rushikeshtangirala/hexapod_new/docs/review/Paper_Comparison.pptx

Comparison with published work

Xiang, L. et al. (2024). Development of a bionic hexapod robot with adaptive gait and clearance for enhanced agricultural field scouting. Frontiers in Robotics and AI, 11:1426269.

| Xiang et al., 2024 | Our project
Topology | 6 legs × 3 DOF, tripod gait as base | Same
Structure | Carbon fibre and CNC aluminium, under 10 kg | 3D printed PLA, 3.39 kg
Foot trajectory | Sinusoidal joint modulation. IK deliberately avoided at run time | Closed-form analytic IK, solved at 50 Hz
Commanding | A gait mode is selected | A body velocity is commanded, stride is derived
Simulation | SolidWorks → Simulink Simscape | AutoCAD → URDF → Gazebo, ros2_control
Sensing | IMU and one force sensor per foot | Foot sensors modelled, currently disabled
Validation | Field trials: slopes to 17°, pitch −11.5° to 8.6°, 14.4 % energy saved per obstacle | 498 offline assertions, IK exact to 3.5×10⁻¹⁶ m

The key difference
They avoid inverse kinematics at run time because numerical IK is expensive. Ours is closed form, so it costs a fixed handful of trigonometric calls and buys the ability to command a body velocity directly.

Where we sit
They have hardware and field trials; we have complete simulation and proven mathematics. Their sensing package is essentially our next-phase list.

Notes: One slide, kept separate from the main deck.

Why this paper: it is nearly the same machine. Six legs, three degrees of freedom each, tripod gait as the starting point, kinematics presented, simulation before hardware. So every difference is a real engineering choice rather than an accident of scale.

Their contribution is a terrain-adaptive gait with two clearance modes, 6 cm marching and 18 cm step-over, so the robot climbs obstacles instead of walking around them. That saves 14.4 percent of the energy per obstacle.

THE POINT TO MAKE. They deliberately avoid inverse kinematics at run time. The paper says computing landing points with IK generates many complex computations and costs time and energy, so they drive the joints with sinusoids instead. That objection applies to NUMERICAL IK, which iterates. Ours is closed form: a fixed handful of trigonometric calls, no iteration, no convergence risk. It is cheap, and it buys something their method cannot have. With sinusoids you select a gait mode. With analytic IK you command a body velocity and the stride for every leg follows from geometry, which is why walking, strafing and turning are one piece of code.

Say it in one line: they trade commandability for computation, we trade computation for commandability, and closed form is what makes that trade affordable. Both are correct engineering. Theirs is right for a battery-limited scouting robot where cost of transport is the headline metric.

Second point, validation. They validate empirically in the field, which needs hardware. We validate formally offline. Complementary, and ours caught a sign error that field testing would likely have dismissed as needing tuning.

Do not imply parity of stage. Say plainly: this paper is where we intend to be at the end of the project.

If asked what we would do differently after reading it: adopt cost of transport as a metric, we have no energy measure at all; add the IMU earlier; and reconsider using CNC aluminium for stressed parts rather than printing everything, which is how they reach 8 kg payload.
