rushikeshtangirala/hexapod_new/docs/review/Hexapod_First_Review_FINAL.pptx

18-DOF Walking Hexapod Robot

Design, Kinematic Analysis and Simulation in ROS 2 and Gazebo

First Review

Pappu Sai Varun (23BME7002)
Akshay Veeranki (23BME7009)
Mohammed Shreyanshu Gumshi (23BME7015)
Tangirala Rushikesh (23BME7073)
Guide: Dr Santosh Kumar Sahu
Department of Mechanical Engineering, VIT-AP University

Notes: Good morning. We are presenting the first review of our final year project, an eighteen degree of freedom walking hexapod robot.

We designed the robot in AutoCAD, analysed the parts in ANSYS, studied the foot trajectory in MATLAB, and built a full simulation in ROS 2 and Gazebo where it now walks under our control.

## Slide 2

Why a hexapod

Six legs turn balancing into a geometry problem

• Wheels need continuous ground. Legs only need somewhere to place a foot.
• Stable when the centre of mass sits inside the triangle of feet on the ground.
• Three feet is the minimum for a triangle, so three legs can lift at once.
• Stability is checked with geometry, not controlled continuously.

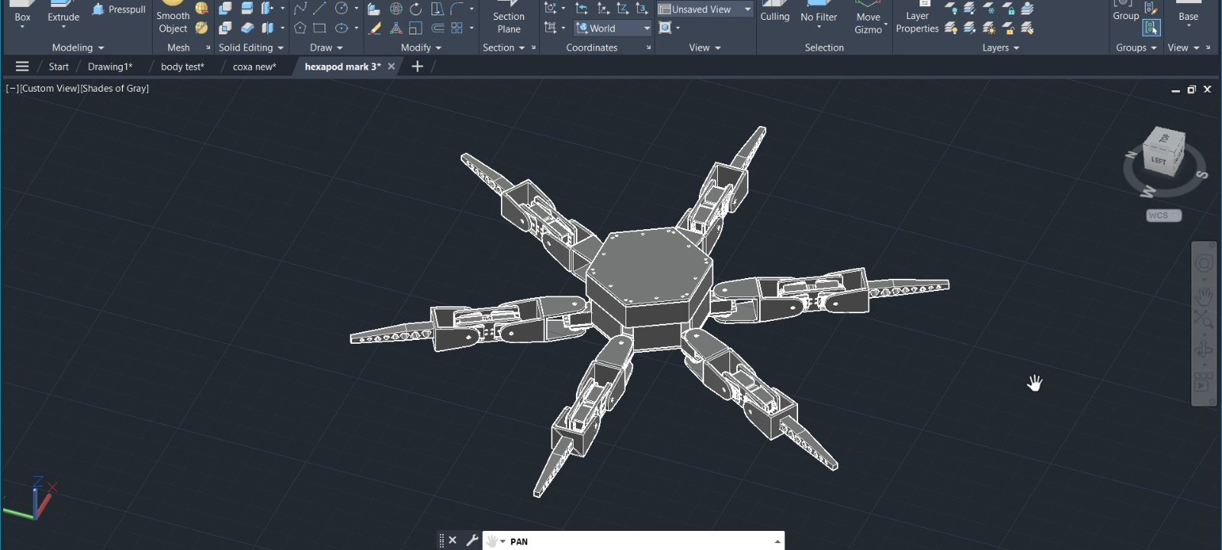
[picture p1: figure]

AutoCAD assembly, six legs about a hexagonal chassis

Notes: Why legs and not wheels. Wheels need continuous ground, legs only need places to put a foot.

Why six legs. A robot is stable when its centre of mass sits inside the triangle of feet touching the ground. Three feet is the minimum for a triangle, so a hexapod can lift three legs and stay stable. Stability becomes something we CHECK with geometry rather than something we control every instant, like a biped must.

## Slide 3

Objectives

Accurate model
AutoCAD to ROS 2, with measured masses and inertia

1

Solve the leg exactly
Closed form forward and inverse kinematics

2

Analyse the motion
Foot path, velocity, acceleration and force in MATLAB

Check the structure
ANSYS on the loaded parts

3

4

Make it walk
Tripod gait from a velocity command, simulated in Gazebo

5

Stay hardware ready
Moving to servos is a settings change

6

Notes: Our objectives. Read them, do not linger.

Objective two is the mechanical core: an exact closed form solution for the leg, not a numerical one.

Objective six is what matters for the next phase. The software is arranged so that moving to real servos is a settings change, not a rewrite.

## Slide 4

The leg

Three joints per leg, eighteen in the robot

Joint functions
Coxa θ₁ swings the leg sideways, about a vertical axis
Femur θ₂ lifts and lowers, about a horizontal axis
Tibia θ₃ extends the foot, about a parallel axis

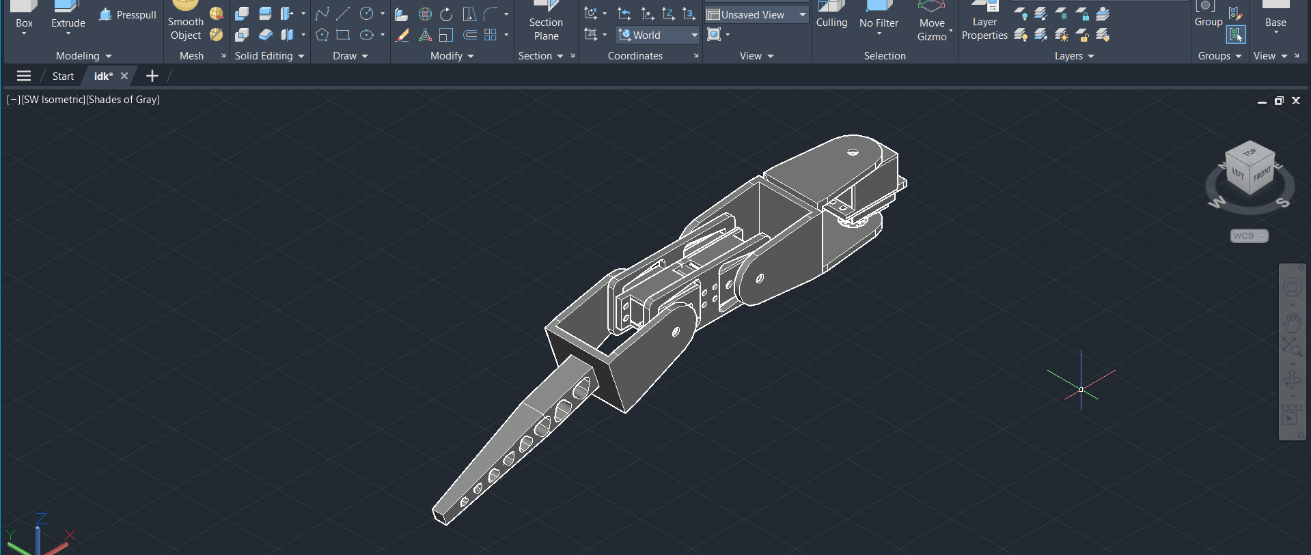
[picture p2: figure]

18

6

joints

legs

3.39

25

AutoCAD, single leg assembly

kg

links

Notes: This is one leg. Three joints, named after insect anatomy, which is the convention in legged robotics.

Coxa turns about a vertical axis and swings the leg sideways. Femur and tibia both turn about horizontal axes and move the foot in a vertical plane.

Point at the CAD: the three pivots, and the servo mounting at each.

## Slide 5

Mechanical parts

Every part modelled in AutoCAD and designed for 3D printing

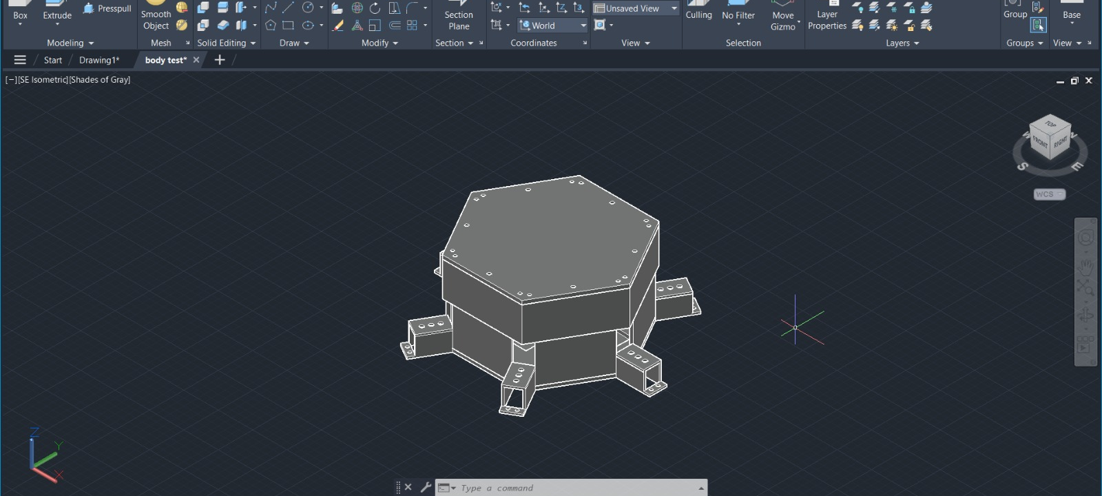
[picture p3: figure]
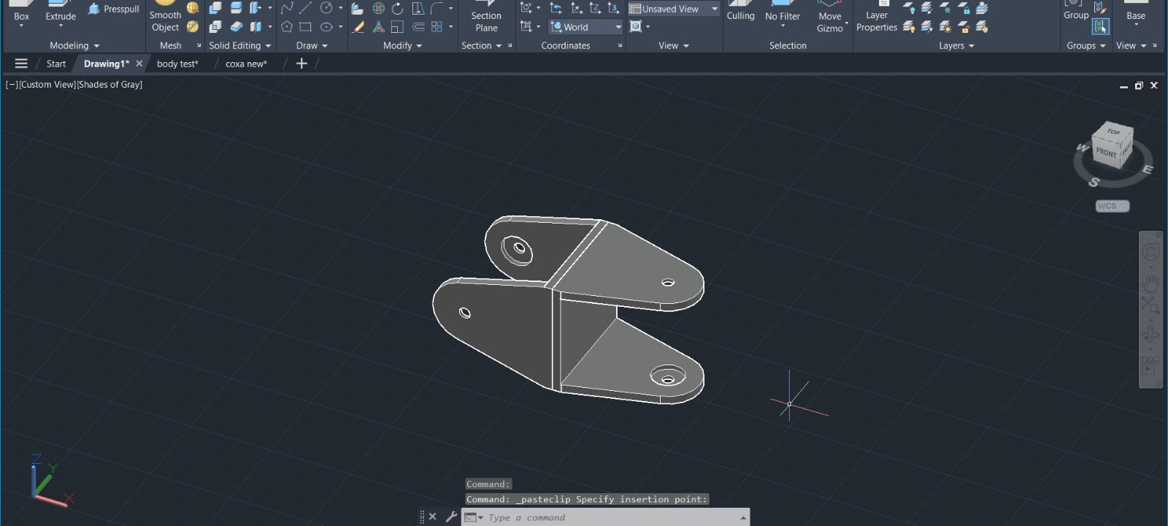
[picture p4: figure]

coxabracket

Chassis

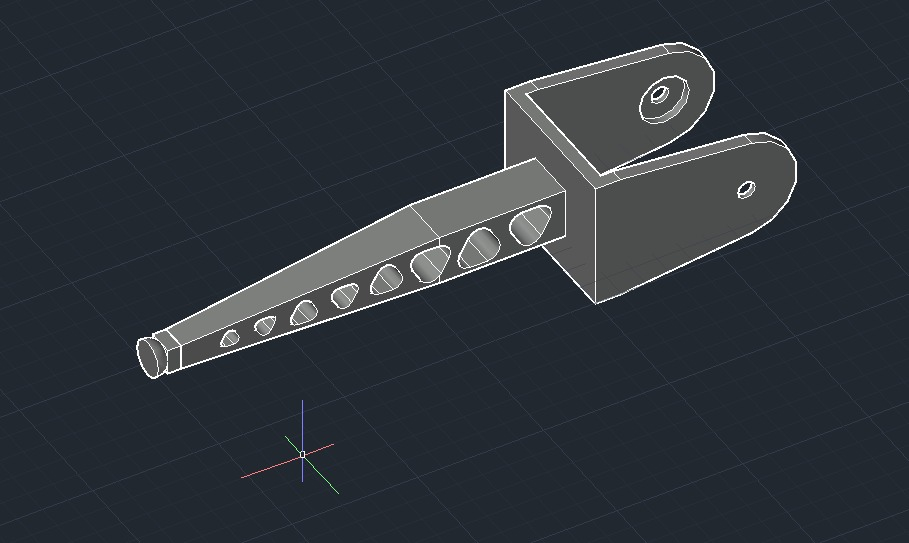
[picture p5: figure]

Tibia

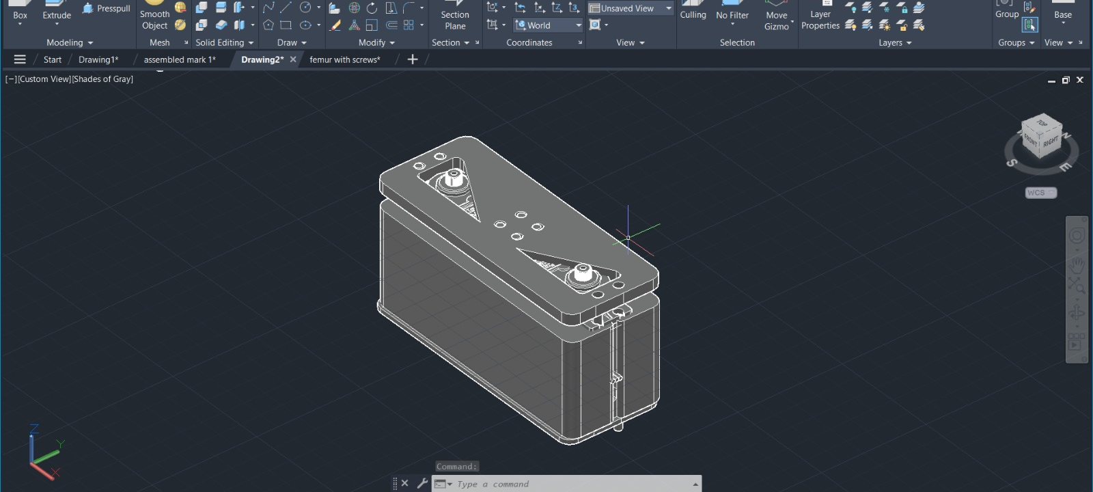
[picture p6: figure]

femur joint

Notes: The individual parts, all modelled by us in AutoCAD.

The chassis is a hexagonal frame carrying six coxa servos, the battery and the electronics. The femur is a bracket. The tibia is the long reaching member that touches the ground.

All parts are designed for 3D printing in PLA, which is what sets the masses we use in simulation.

## Slide 6

The leg as a mechanism

An RRR serial chain, and one deliberate axis choice

• Three revolute joints in series, so three degrees of freedom per leg.
• Coxa axis vertical. Femur and tibia axes horizontal and parallel to each other.
• Because those two axes are parallel, the leg beyond the coxa stays in ONE vertical plane.
• The coxa angle only selects which plane that is.
• So a 3D positioning problem reduces to a 2D two-link problem, which has an exact solution.
• In stance, the loaded legs plus the ground and body form closed chains.

Six identical legs, mounted at different yaw angles, so one solution serves all of them.

Why this matters
A general 3-DOF chain needs a numerical solver, which is slower and can fail to converge in the middle of a step.
Our arrangement gives a closed form answer every time, in a fixed number of operations.

Notes: Treating the leg as a mechanism. It is an open serial chain of three revolute joints, an RRR chain, so it has three degrees of freedom and can place its foot anywhere in a three dimensional workspace.

The important structural point is the axis arrangement. The coxa axis is vertical. The femur and tibia axes are horizontal AND PARALLEL to each other. Because those two are parallel, everything beyond the coxa is confined to one vertical plane.

In stance, three legs plus the ground and the body form closed kinematic chains, which is what carries the load.

## Slide 7

Forward kinematics

Given the joint angles, where is the foot?

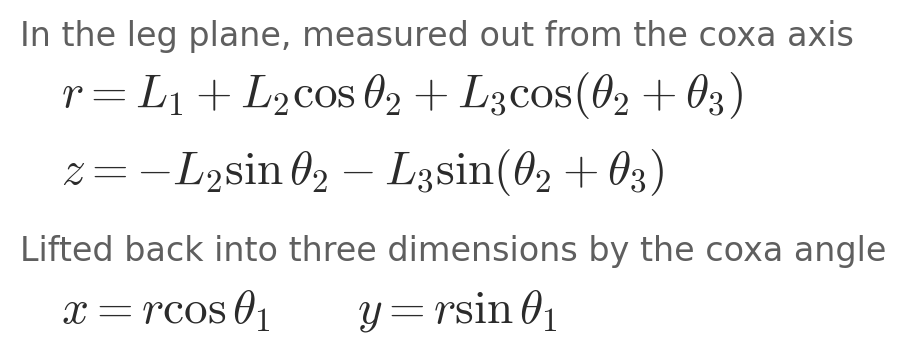
[picture p7: figure]

Link lengths
L₁ = 150.0 mm coxa
L₂ = 116.6 mm femur
L₃ = 150.0 mm tibia
Positive θ₂ and θ₃ move the foot downward, from the right handed axis convention.

Verified stance solution: θ₁ = 0°, θ₂ = 15.44°, θ₃ = 67.82°, giving a foot 0.280 m out and 0.180 m below the body.

Notes: Forward kinematics. Given the three joint angles, where is the foot.

Work in the leg plane first. r is how far out the foot is from the coxa axis, z is how far down. Each term is one link projected onto that plane.

Then lift it back into three dimensions by rotating through the coxa angle.

The minus signs on z come from the axis convention: rotation about the positive Y axis carries the X direction toward negative Z, so a positive femur angle moves the foot DOWN. We kept the mathematically clean right handed axes and documented the consequence.

## Slide 8

Inverse kinematics

Given the foot position, what should the joint angles be?

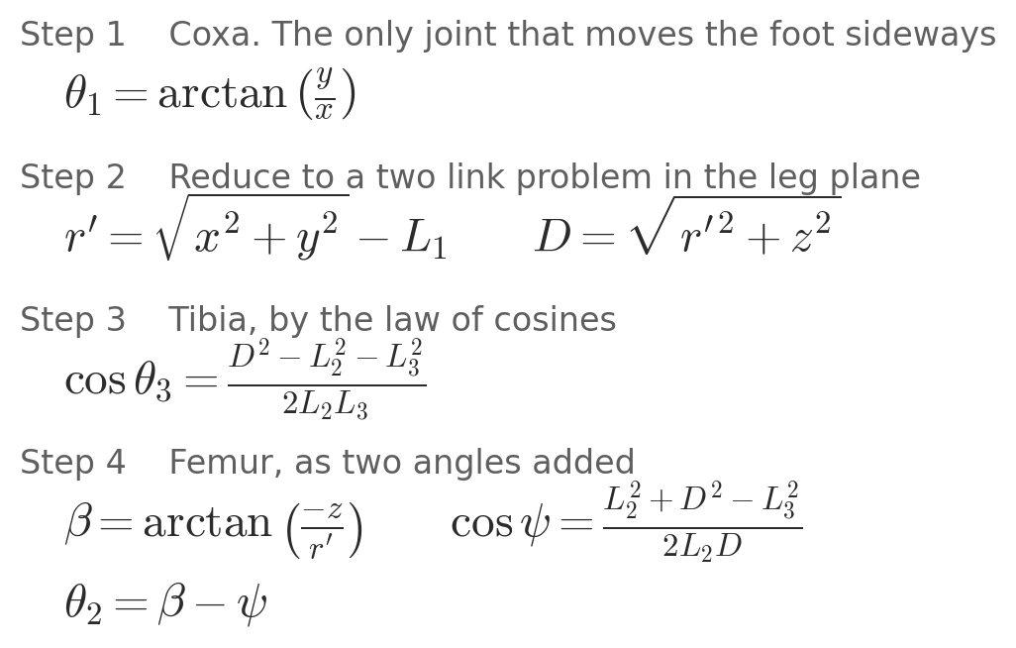
[picture p8: figure]

Checked numerically: forward → inverse → forward closes to 3.5 × 10⁻¹⁶ m, the precision limit of the computer.

Why it matters
This runs 50 times a second, for all six legs, every time the robot takes a step.
Closed form means a fixed cost and no possibility of failing to converge part way through a step.

Notes: Inverse kinematics, the one that actually runs on the robot fifty times a second. Given where we want the foot, what should the joint angles be.

Step one: the coxa is the only joint that can move the foot sideways, so its angle comes straight from the horizontal direction to the target.

Step two: shift the origin out to the femur joint. Now it is two links reaching a point, and D is the straight line distance to it.

Step three: the tibia angle from the law of cosines on the triangle made by the two link lengths and D.

Step four: the femur angle is two angles added. Beta is the elevation of the target, psi is the angle between the femur and the line to the target.

No iteration anywhere. Same number of operations every time.

## Slide 9

Mass and inertia

Calculated from the CAD volumes, then the servos added

Part | Length | Mass | Made up of
Body | 312.7 mm | 1.310 kg | frame, 6 coxa servos, battery, electronics
Coxa | 150.0 mm | 0.201 kg | printed 0.141 + femur servo 0.060
Femur | 116.6 mm | 0.101 kg | printed 0.041 + tibia servo 0.060
Tibia | 150.0 mm | 0.035 kg | printed part only

Inertia tensors
Computed in closed form for a box and for cylinders, about each part's own centre of mass. These are exact, not estimates.
Total mass 3.39 kg. Standing on three legs, each foot carries about 10.9 N.

Servo mass belongs to the part it is bolted to, not the part it moves.

Notes: The masses that go into the simulation. These are calculated from the measured volume of each CAD part at PLA density, then the servo masses added.

One detail that is easy to get backwards: a servo's mass belongs to the part it is BOLTED TO, not the part it drives. The tibia servo sits on the femur. All six coxa servos sit on the body.

What matters most is not the absolute mass but the RATIO across each joint, because the physics solver inverts the mass matrix every step and its conditioning depends on those ratios.

## Slide 10

Structural analysis

ANSYS on the parts that carry the standing load

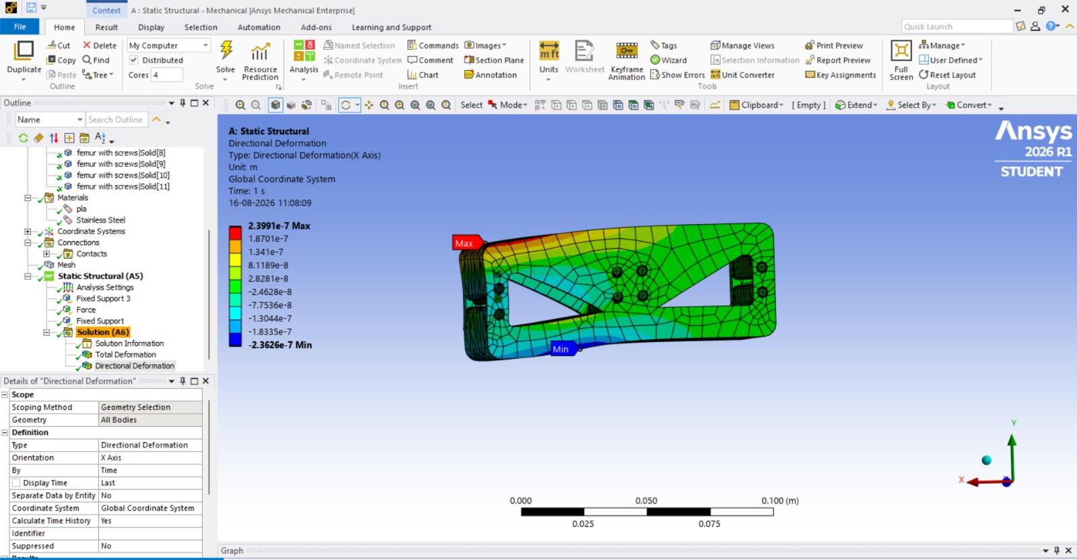
[picture p9: figure]

Static structural, femur bracket

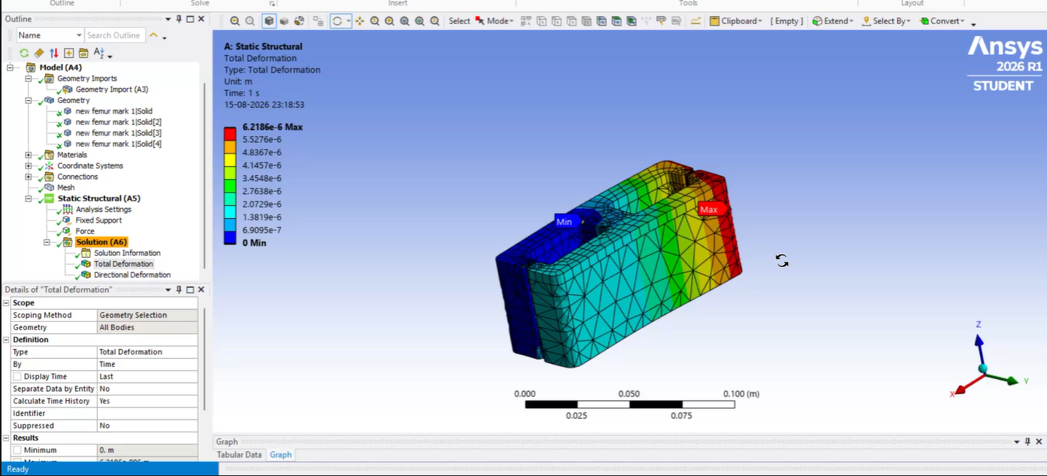
[picture p10: figure]

Total deformation, chassis

Load case: 3.39 kg standing on three legs → about 10.9 N per foot Peak stress [ ] Max deformation [ ] Factor of safety [ ]

Notes: Structural analysis in ANSYS on the loaded parts.

The load case comes straight from the mass figure on the previous slide. The robot weighs 3.39 kg, it stands on three legs at a time, so each foot carries about 10.9 newtons.

Give your peak stress and the factor of safety, then the maximum deflection. If the parts passed, say so plainly.

## Slide 11

Tripod gait

Three feet always down, and the stride follows from the speed

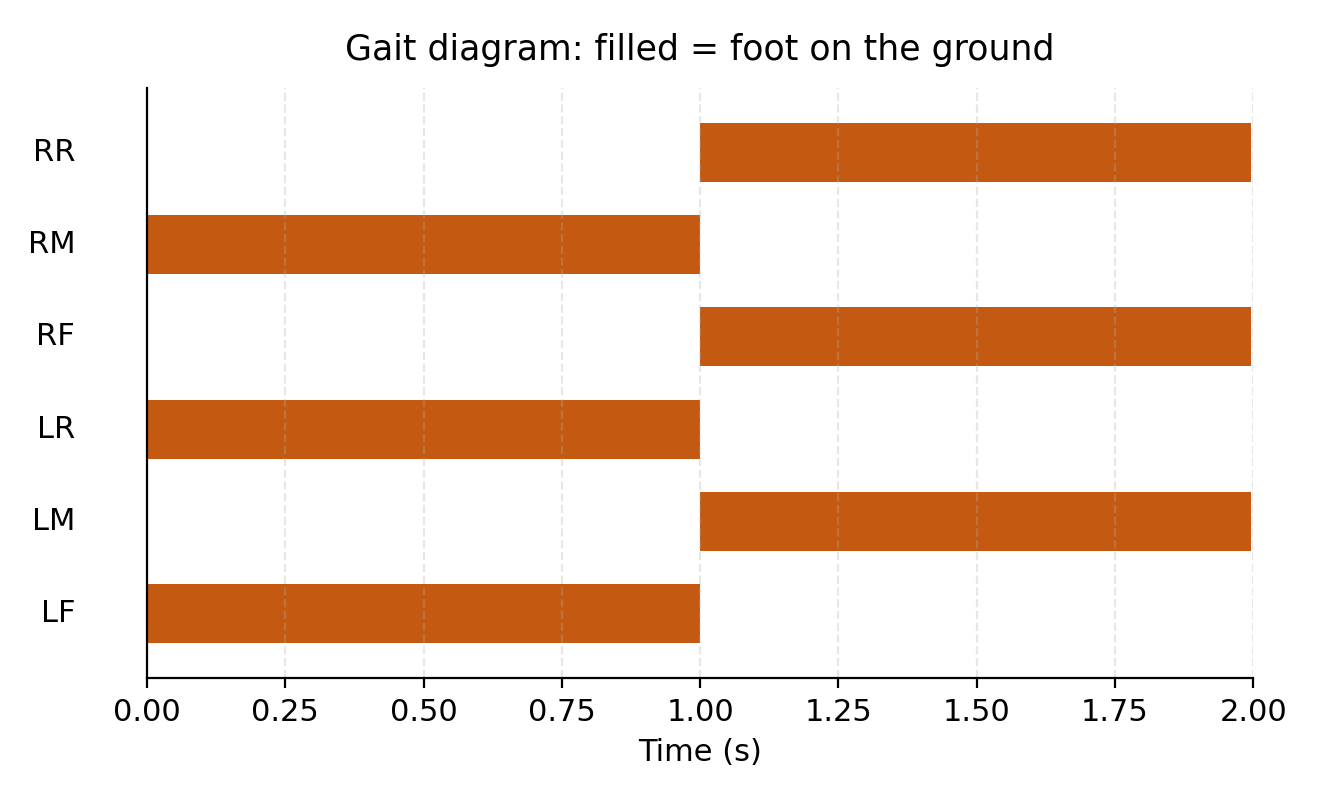
[picture p11: figure]

Step length is not a tuning knob. It is forced by the commanded speed and the time a foot spends on the ground. Choosing it freely would make the feet slide.

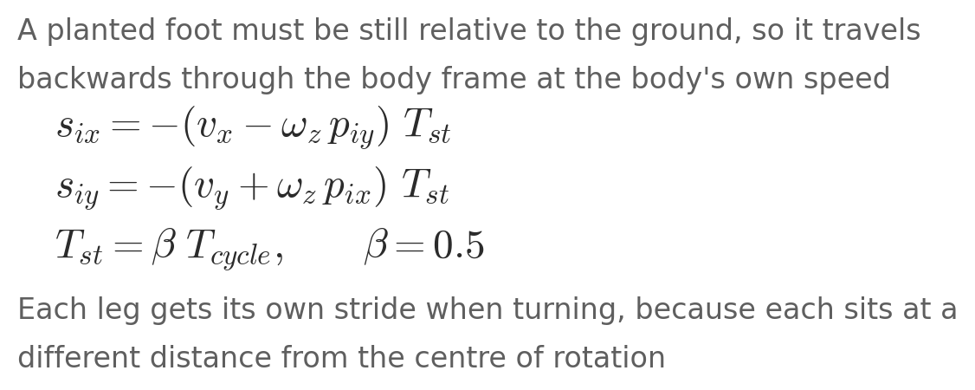
[picture p12: figure]

Notes: The walking pattern. Six legs in two groups of three, exactly half a cycle apart. One group pushes while the other swings forward.

The diagram: filled bars are feet on the ground. Read down any vertical line and you always cross exactly three filled bars. That is the stability condition, satisfied at every instant.

The equation is the important part. We do not choose the step length. A foot on the ground must be still relative to the ground, so it has to travel backwards through the body frame at exactly the body's speed. That forces the stride.

And because each leg sits at a different distance from the centre of rotation, each gets its own stride when turning. That single expression is why walking, strafing and turning are one piece of code.

## Slide 12

Swing trajectory

The shape of one step, and why the ends matter

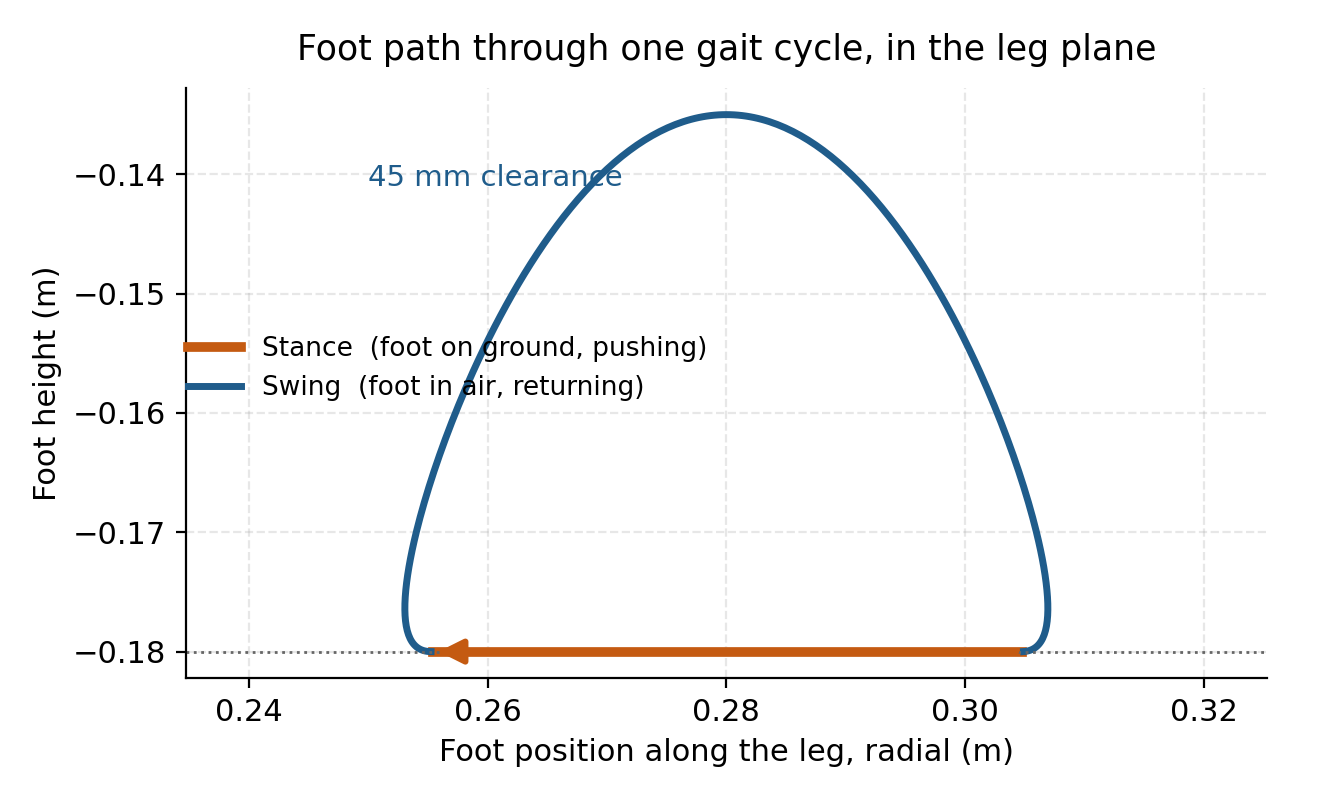
[picture p13: figure]
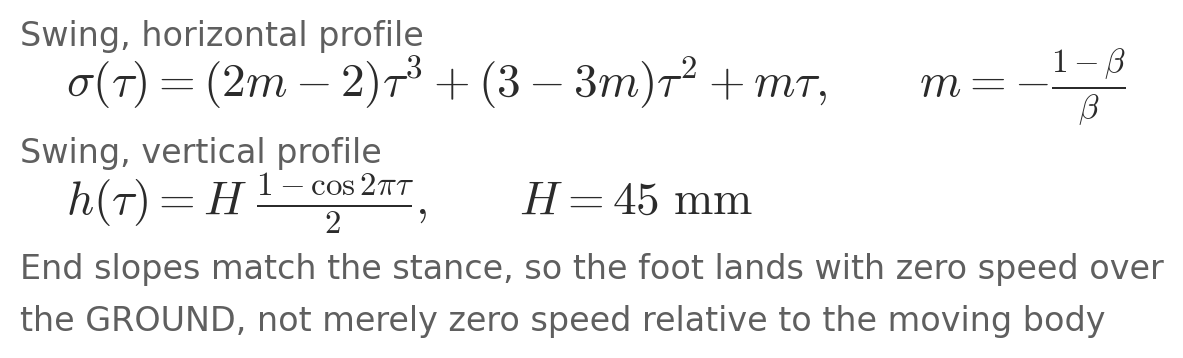
[picture p14: figure]

The end slopes are matched to the stance, so the foot touches down with zero speed over the ground rather than zero speed relative to the moving body.

Notes: The path a foot follows through one full cycle, drawn in the leg plane.

Orange is stance, a straight line along the ground, sweeping backwards to push the robot forwards. Blue is swing, lifting 45 mm clear and returning to the front.

The equations define that shape. The vertical profile is a raised cosine, which arrives with zero downward speed. The horizontal profile is a cubic.

The subtle part is the end slopes. We match them to the stance velocity, so the foot lands with zero speed relative to the GROUND. An earlier version landed with zero speed relative to the BODY, which sounds right but means the foot is moving at full body speed across the ground at the moment it touches.

## Slide 13

No-slip verification

The stance foot does not move relative to the ground

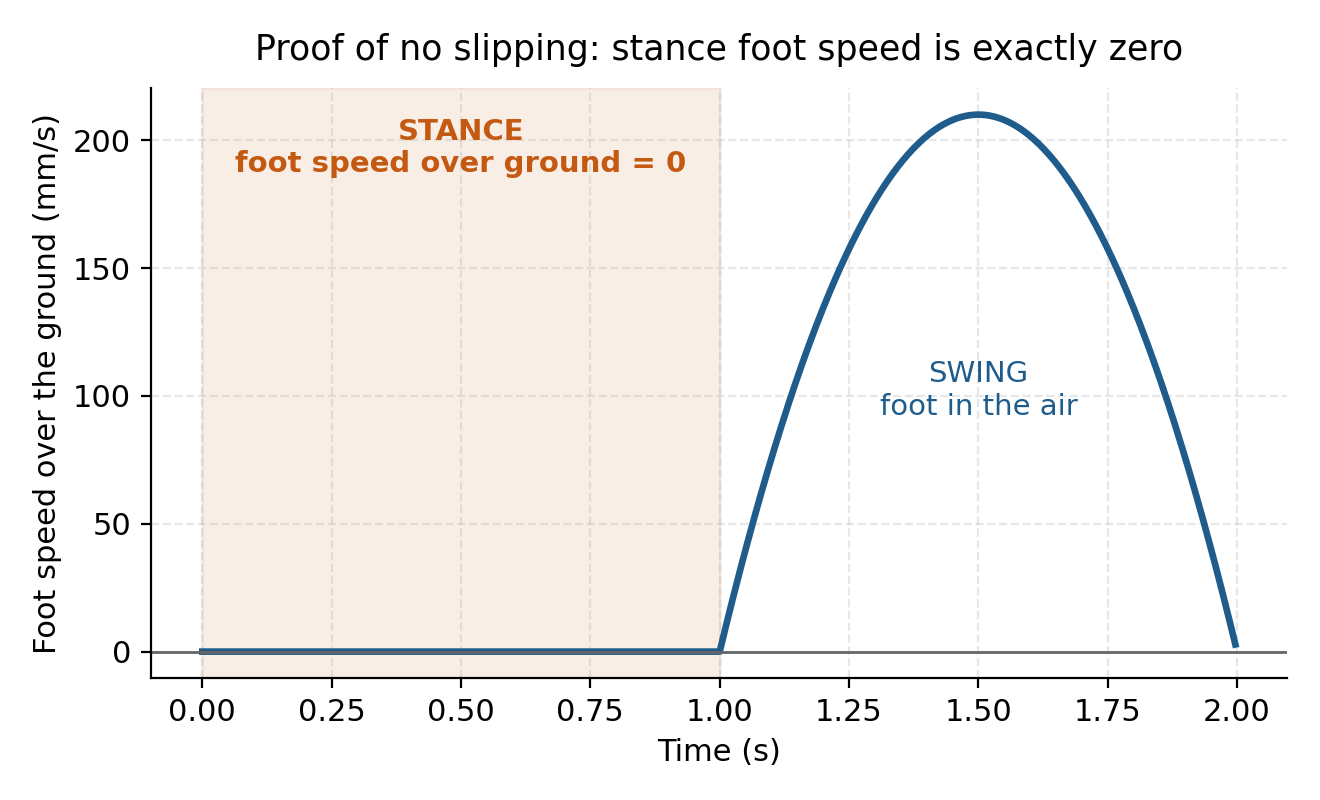
[picture p15: figure]

Why this is the key plot
A foot that slides while carrying load wastes energy, wears the contact surface and destroys odometry.
The flat zero through the whole stance is what says the gait geometry is right.
Checked automatically at every phase, on every code change.

Notes: This plot is the proof that the gait is correct, and it is the one to dwell on.

The vertical axis is the speed of the foot over the GROUND, not relative to the robot. During stance, shaded orange, it is exactly zero for the whole phase. The foot is planted and does not slide.

During swing the foot moves, which is fine, it is in the air.

If the stance part of this curve were not flat at zero, the robot would be scuffing its feet and losing energy and odometry. This is checked automatically at every phase, every time we change the code.

## Slide 14

MATLAB study: the foot path

Modelling one step as a Bézier curve before implementing it

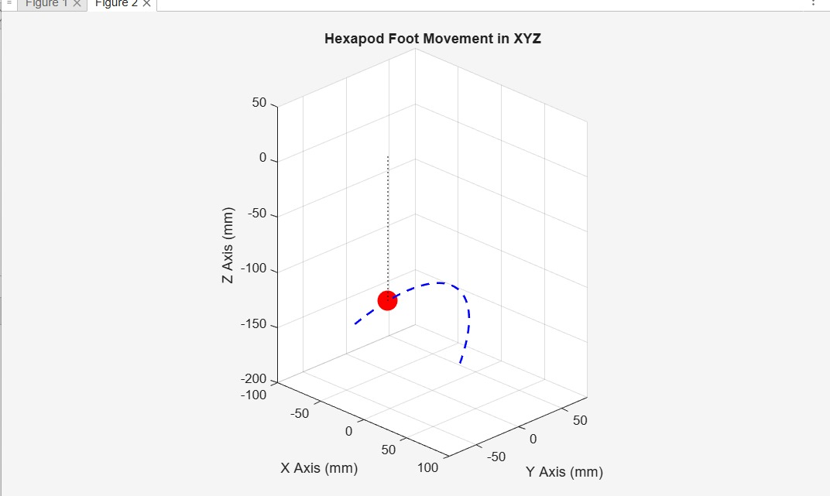
[picture p16: figure]

Foot movement in XYZ

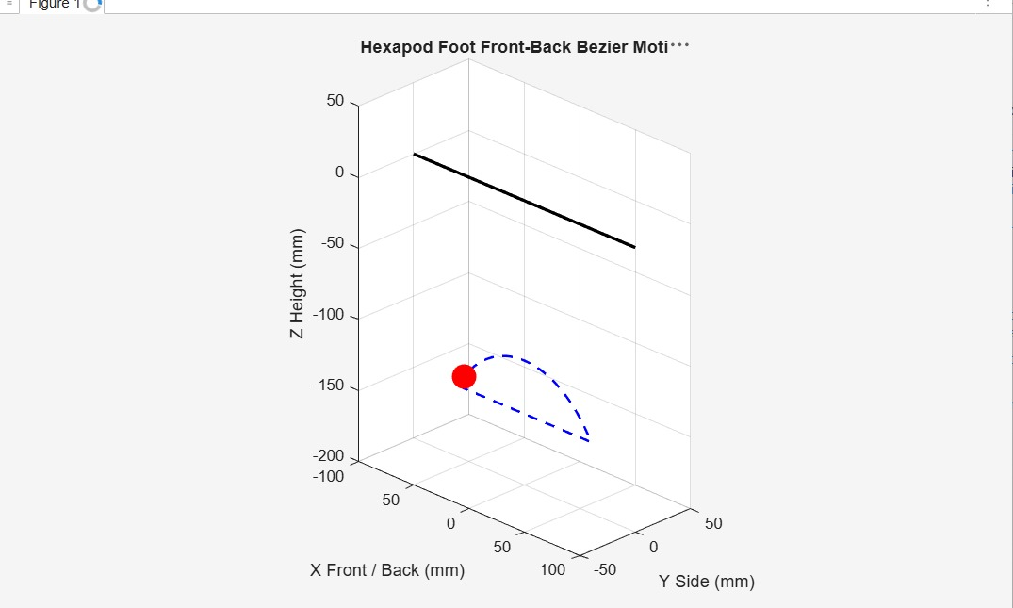
[picture p17: figure]

Fore and aft view of the same path

The path is smooth and closed. Lift height and stride length are set by the control points of the curve.

Notes: Now the MATLAB study. Before implementing anything we modelled the foot trajectory as a Bezier curve and analysed it.

These two views show the path of one foot through a complete step. The dashed blue curve is the trajectory, the red marker is the foot. The left view is the full three dimensional path, the right shows the fore and aft travel against the reference line.

What we take from it: the path is smooth and closed, it returns exactly to where it started, and the lift height and stride are set by the control points of the curve.

## Slide 15

MATLAB: velocity and acceleration

Differentiating the path gives the servo requirements

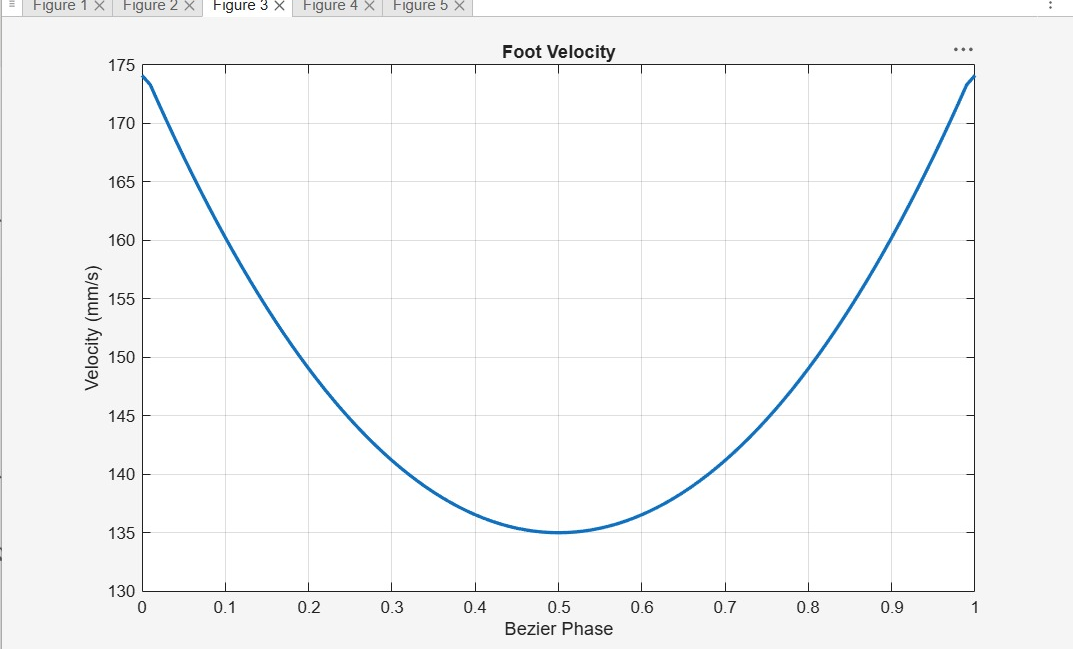
[picture p18: figure]

Foot velocity through the step

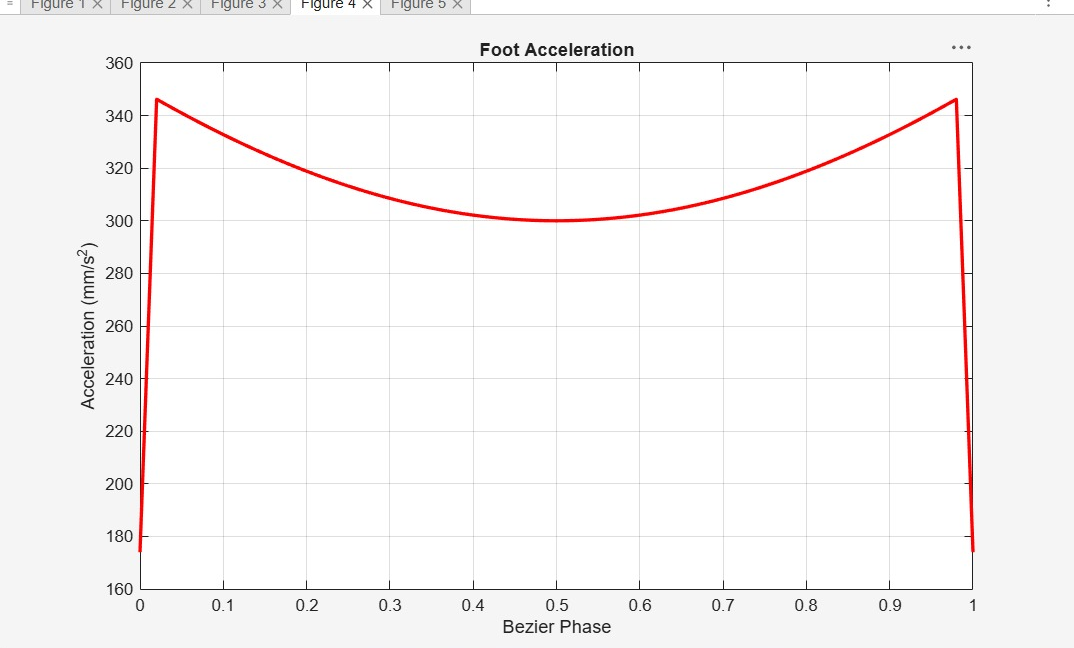
[picture p19: figure]

Foot acceleration through the step

Peak velocity sets the speed the servo must deliver. Peak acceleration times the moving mass gives the inertial load on top of holding the robot up. Both curves are smooth, so there is no impulsive load on the gearbox.

Notes: Differentiating that path gives velocity and acceleration through the step.

Velocity: 174 mm/s at the start, falling to 135 at mid phase, back to 174 at the end. So the foot is fastest at the transitions and slowest in the middle of the curve.

Acceleration: the same U shape, 345 down to 300 and back, in mm per second squared.

Why we care. The peak velocity sets the speed a servo must be able to deliver. The peak acceleration, times the moving mass, gives the inertial load the servo has to overcome on top of holding the robot up. Both curves are continuous with no spikes, which is what you want, because a discontinuity here would be an impulsive load on the gearbox.

## Slide 16

MATLAB: foot force

What the leg has to carry through a step

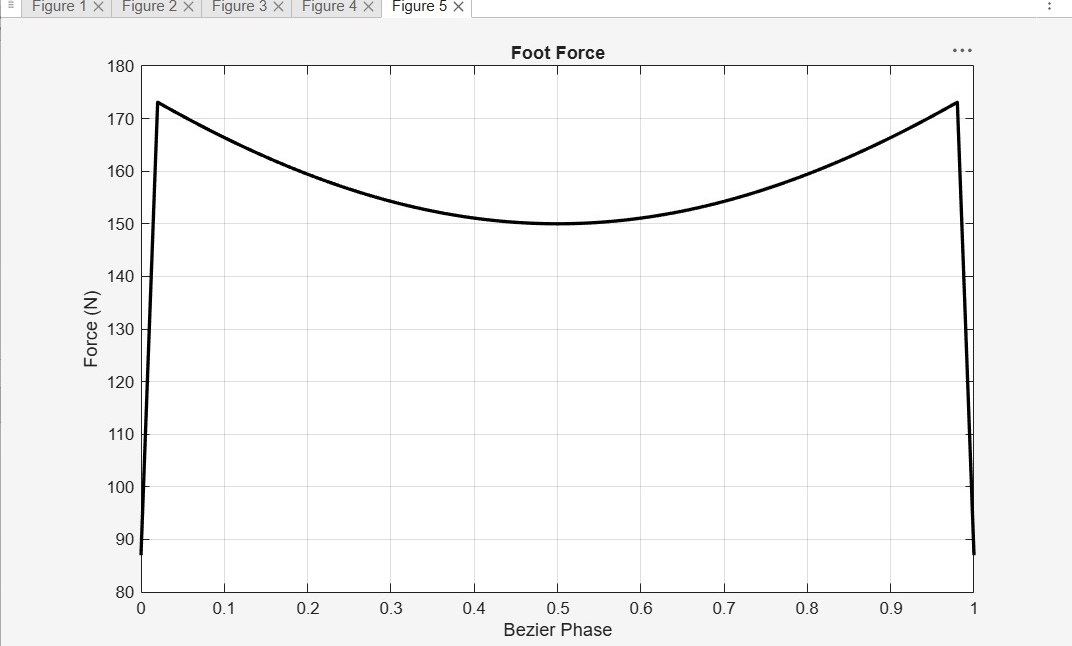
[picture p20: figure]

Foot force against phase

Why this sizes the servo
Force is highest at the start and end of the phase, lowest in the middle. It follows the acceleration curve.
Force multiplied by the link length gives the torque the joint must produce, which is how the servo class was chosen.
Static component: 10.9 N per foot from the mass budget.

Notes: Foot force through the step, from the same MATLAB model.

The force is highest at the beginning and end of the phase and lowest in the middle, ranging from about 173 newtons down to 150.

The shape follows the acceleration curve, which is what you expect: where the foot is being accelerated hardest, the force is largest.

This is the number that sizes the joint. Combined with the link length it gives the torque the servo has to produce, and that is how we chose the servo class.

If asked how the force is derived, say it is the loaded foot force through the trajectory from the MATLAB model, and that the static component is the 10.9 N per foot from the mass budget.

## Slide 17

MATLAB: joint angles

The inverse kinematics applied along the whole path

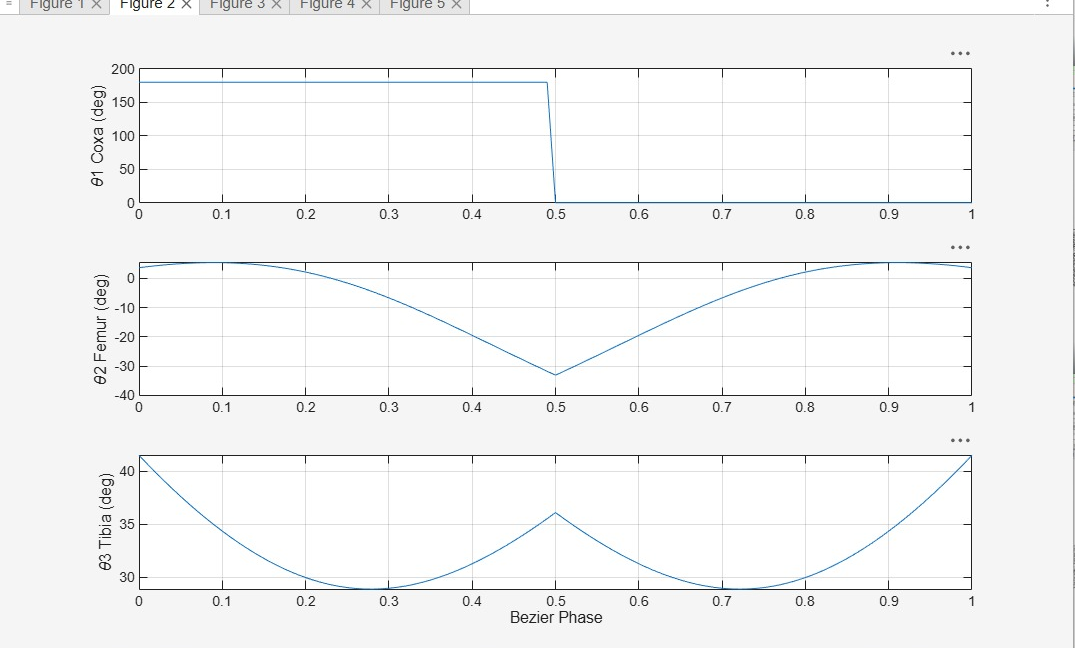
[picture p21: figure]

θ₁ coxa, θ₂ femur, θ₃ tibia against phase

What it confirms
Femur and tibia move smoothly through roughly 30 degrees, well inside their limits.
The whole trajectory is reachable. No point on the path asks the leg for something it cannot do.
These angles are what the controller receives.

Notes: Finally the joint angles that produce that path. This is the inverse kinematics from earlier, applied along the whole trajectory.

Top is the coxa, middle the femur, bottom the tibia, all in degrees against phase.

The femur and tibia curves are smooth and stay within a modest range, roughly 30 degrees of travel, which is comfortably inside the joint limits.

The coxa trace shows a change at mid phase where the leg switches from one side of its axis to the other. Note for us, not for the slide: that step is an angle wrap-around from atan2 and must be unwrapped before it is sent to a servo, or the joint would try to spin a full turn.

## Slide 18

From CAD to simulation model

The same parts, in a form ROS 2 can use

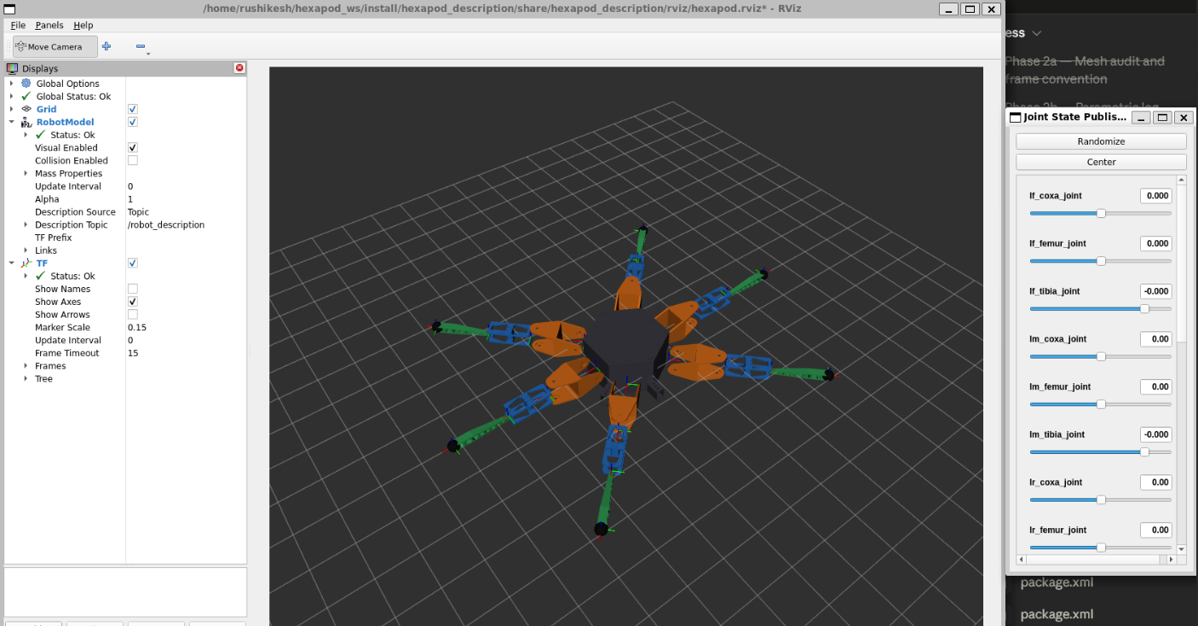
[picture p22: figure]

RViz, the assembled model with all 18 joints

What the model carries
• Shape of every part, from the CAD meshes
• Position and axis of all 18 joints
• Mass and inertia of each link
• Joint limits, friction and damping
Appearance uses the meshes. Contact and inertia use boxes and cylinders, which is far faster and, for the chassis, actually more correct.

Notes: Turning the mechanical design into something the simulator can use.

The CAD parts were exported as STL meshes and assembled into a URDF, which is the standard robot description format. It carries the shape of every part, the position and axis of all eighteen joints, the masses and inertias, and the joint limits.

One choice worth mentioning: the robot LOOKS like the CAD meshes, but for contact and inertia we use simple boxes and cylinders. Full mesh contact across twenty five links would be about a thousand times slower, and the chassis mesh is not watertight so its inertia is not even defined.

## Slide 19

Gazebo simulation

The robot standing and walking under gravity and friction

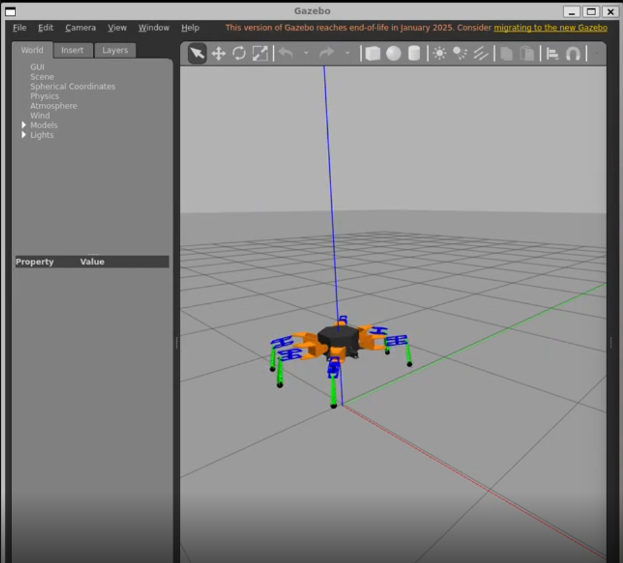
[picture p23: figure]

Standing in the world

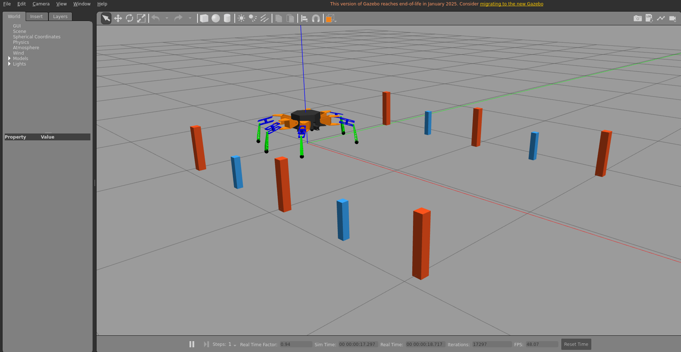
[picture p24: figure]

Walking, distance markers for scale

All 18 joints respond individually. The robot holds its stance under its own weight. The controller tracks commanded angles closely. Three feet stay on the ground throughout the cycle.

Notes: The simulation running. Left, the robot standing in the Gazebo world under gravity, holding its stance. Right, walking, with the markers giving a sense of distance travelled.

What we verified in simulation: all eighteen joints respond individually and correctly, the robot holds its stance under its own weight with about two degrees of sag, the controller tracks commanded joint angles closely, and the tripod pattern keeps three feet down throughout.

The robot is driven by keyboard teleoperation, exactly as it would be on hardware.

## Slide 20

Where we are

Completed
• All parts modelled in AutoCAD
• Structural analysis in ANSYS
• Foot trajectory studied in MATLAB
• Closed form kinematics, verified numerically
• Tripod gait, verified by 498 checks
• Full ROS 2 and Gazebo simulation
• Robot walks under our control

Next phase
• Walking under the full dynamic simulation
• Tuning the joint controllers
• Foot contact sensors to measure slip directly
• Writing the servo driver
• Assembling the physical robot
• Mapping and navigation

Notes: Where we are. Left column is finished and demonstrated today.

Right column is what remains. Do not skip it. A clear statement of what is not yet done reads as competence.

The main outstanding item is walking under the full dynamic simulation with our measured masses. We have measured the behaviour precisely and are working through it.

## Slide 21

Thank you

Questions

Notes: Thank you. Open for questions.

The question to be ready for is whether the walking demonstration is real. Answer: the legs are driven by the real gait and the real inverse kinematics, nothing is animated, and the body moves by the amount those legs geometrically require, because we have proved the feet do not slip.
