rushikeshtangirala/hexapod_new/docs/review/figures/fig2_joint_angles.png

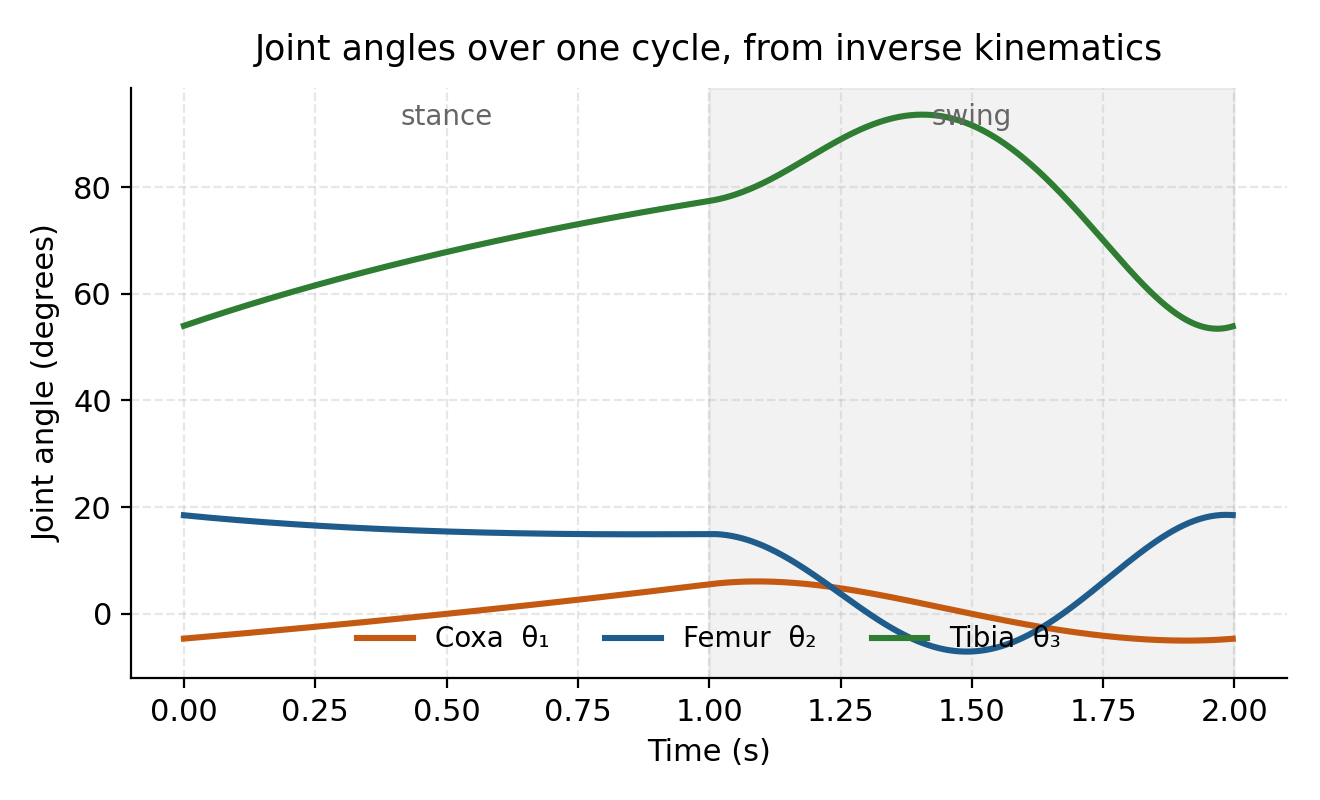
docs/review/figures/fig2_joint_angles.png
