rushikeshtangirala/hexapod_new/docs/review/figures/fig6_stride.png

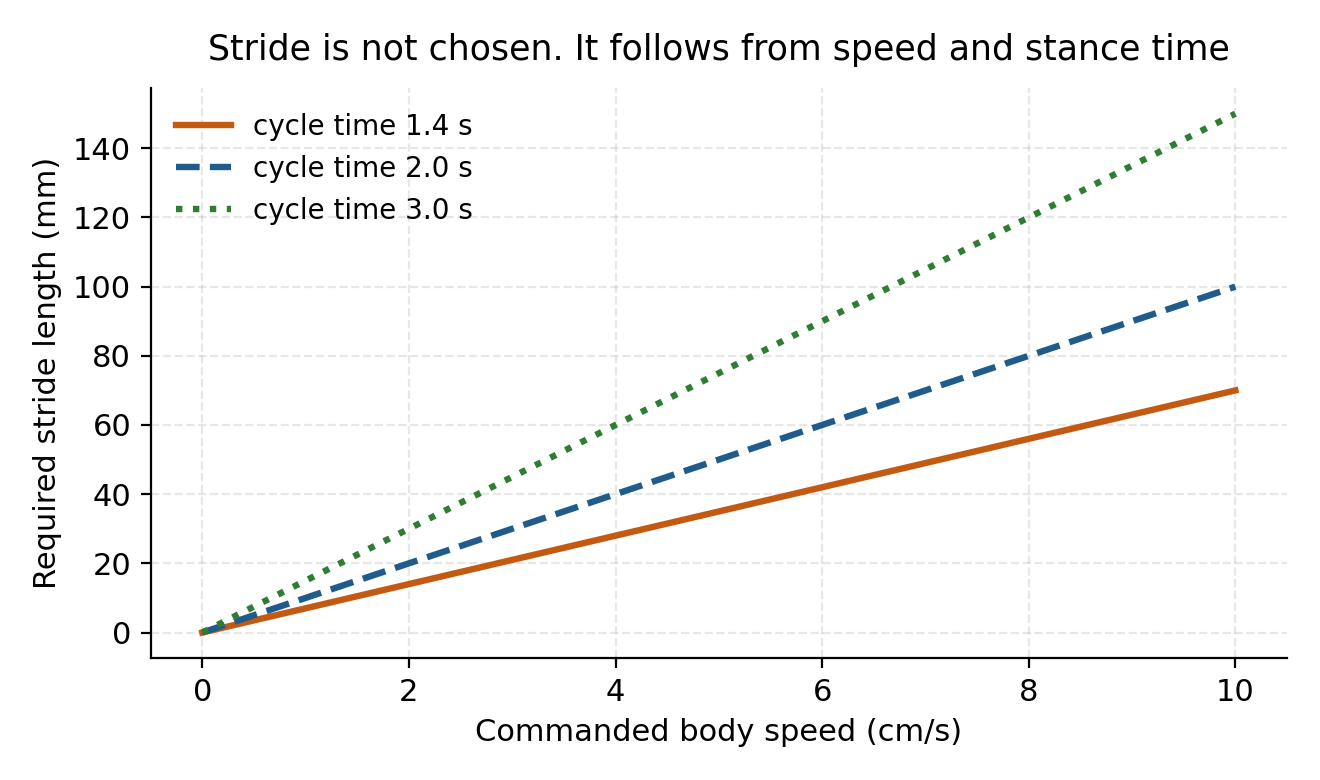
docs/review/figures/fig6_stride.png
