rushikeshtangirala/hexapod_new/src/hexapod_description/meshes/visual/leg assembled.stl

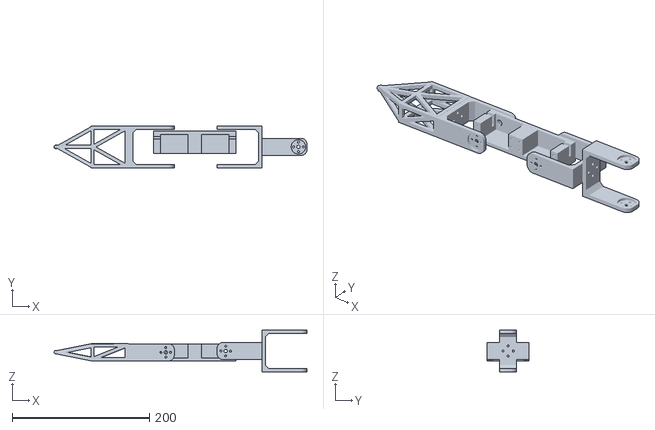
[picture p31: CAD file, 2026-09-12]
src/hexapod_description/meshes/visual/leg assembled.stl
368.5 x 61.3 x 61.0
