rushikeshtangirala/hexapod_new/src/hexapod_description/meshes/visual/coxa.stl

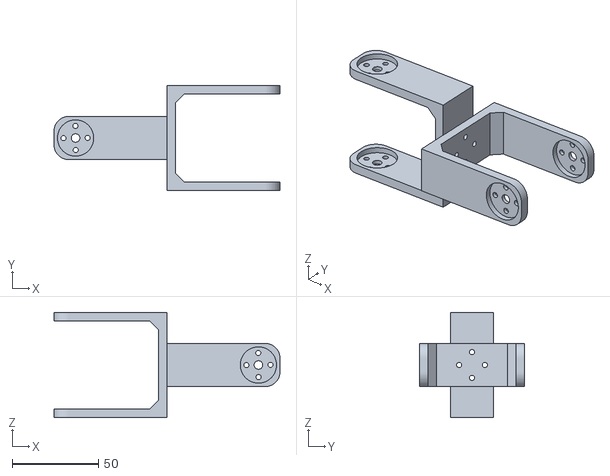
[picture p32: CAD file, 2026-09-12]
src/hexapod_description/meshes/visual/coxa.stl
130.9 x 61.0 x 61.0
