rushikeshtangirala/hexapod_new/src/hexapod_description/meshes/visual/tibia.stl

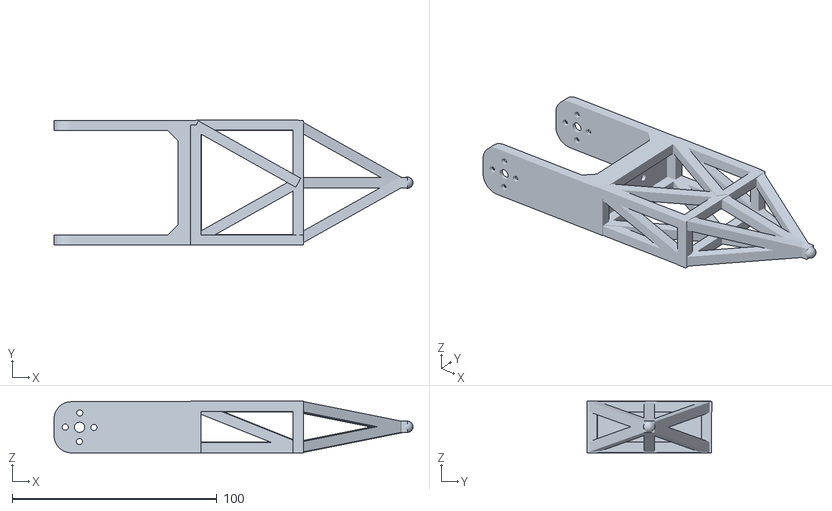
[picture p33: CAD file, 2026-09-12]
src/hexapod_description/meshes/visual/tibia.stl
175.3 x 61.3 x 25.3
