rushikeshtangirala/hexapod_new/src/hexapod_description/meshes/visual/tibia_raw.stl

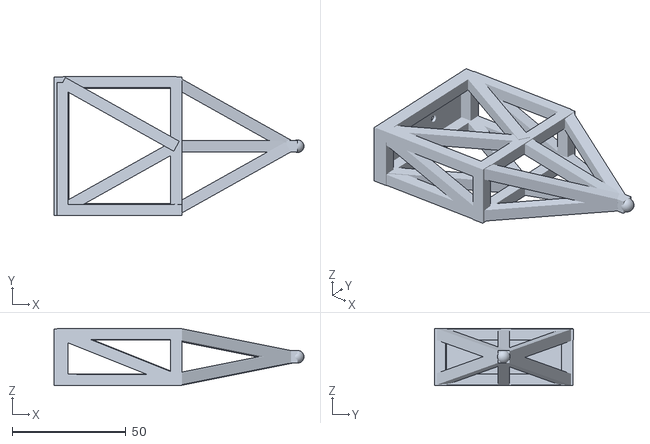
[picture p34: CAD file, 2026-09-12]
src/hexapod_description/meshes/visual/tibia_raw.stl
109.8 x 61.3 x 25.3
