rushikeshtangirala/hexapod_new/src/hexapod_description/meshes/visual/femur.stl

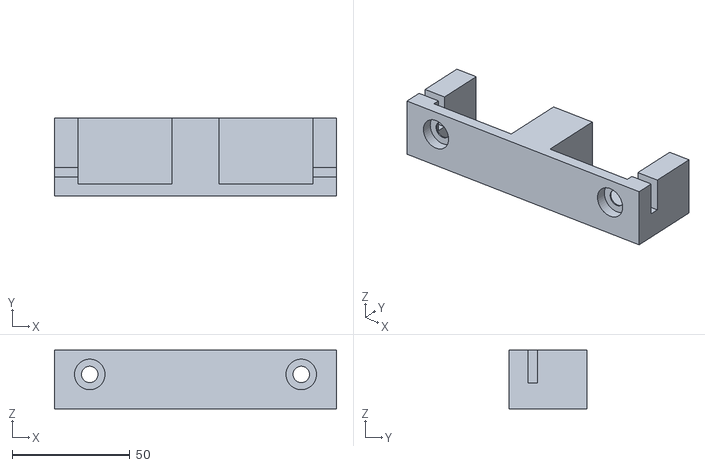
[picture p35: CAD file, 2026-09-12]
src/hexapod_description/meshes/visual/femur.stl
120.0 x 33.0 x 25.0
