rushikeshtangirala/hexapod_new/src/hexapod_description/meshes/visual/coxa_raw.stl

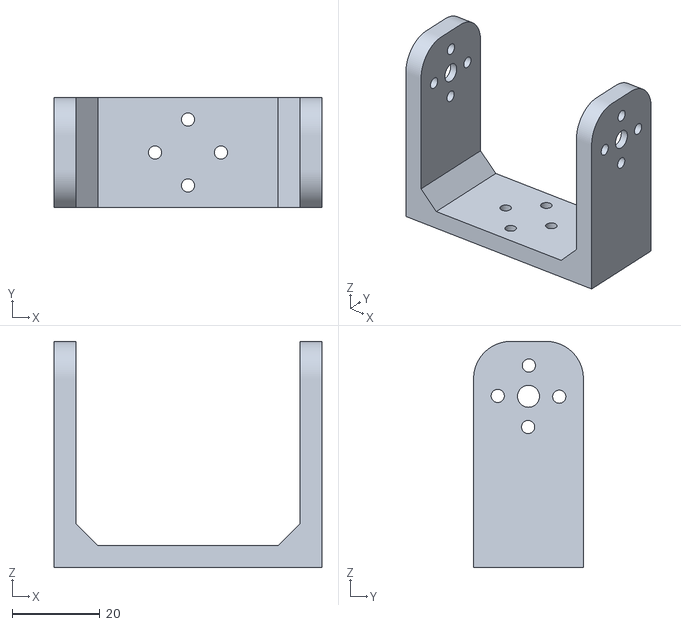
[picture p36: CAD file, 2026-09-12]
src/hexapod_description/meshes/visual/coxa_raw.stl
61.0 x 25.0 x 51.5
