rushikeshtangirala/hexapod_new/src/hexapod_description/meshes/visual/body.stl

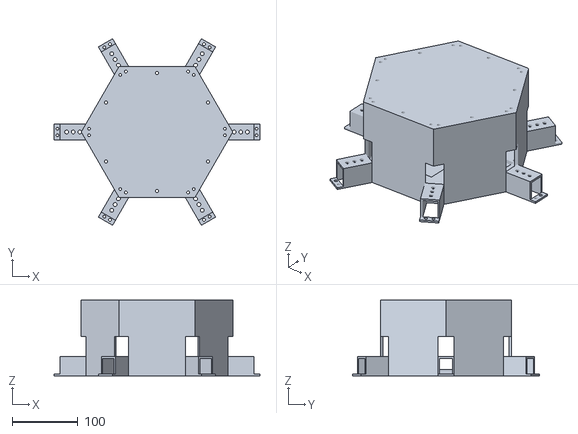
[picture p37: CAD file, 2026-08-11]
src/hexapod_description/meshes/visual/body.stl
312.7 x 283.3 x 115.0
