rushikeshtangirala/hexapod_new/src/hexapod_description/meshes/visual/femur_lower.stl

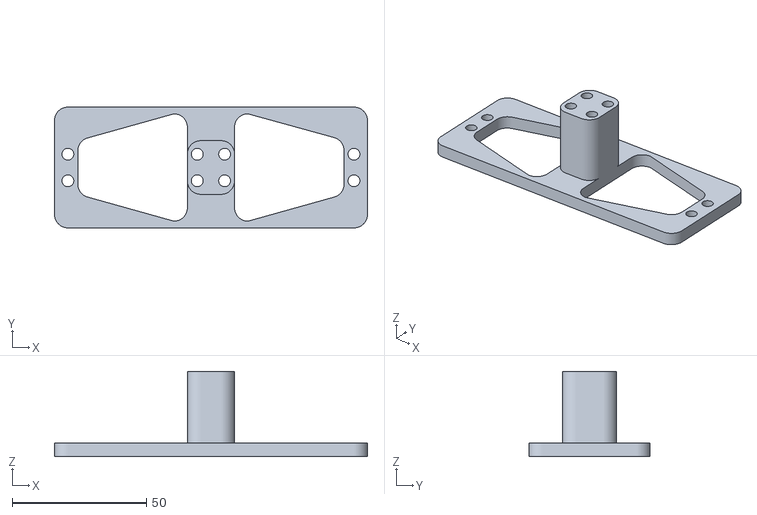
[picture p38: CAD file, 2026-08-11]
src/hexapod_description/meshes/visual/femur_lower.stl
116.6 x 45.0 x 31.7
