rushikeshtangirala/hexapod_new/src/hexapod_description/meshes/visual/femur_upper.stl

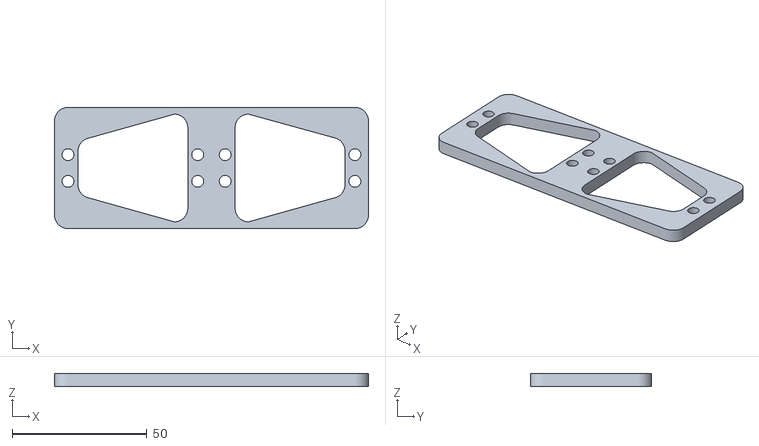
[picture p39: CAD file, 2026-08-11]
src/hexapod_description/meshes/visual/femur_upper.stl
116.6 x 45.0 x 5.00
