rushikeshtangirala/hexapod_new/src/hexapod_description/meshes/visual/body test.stl

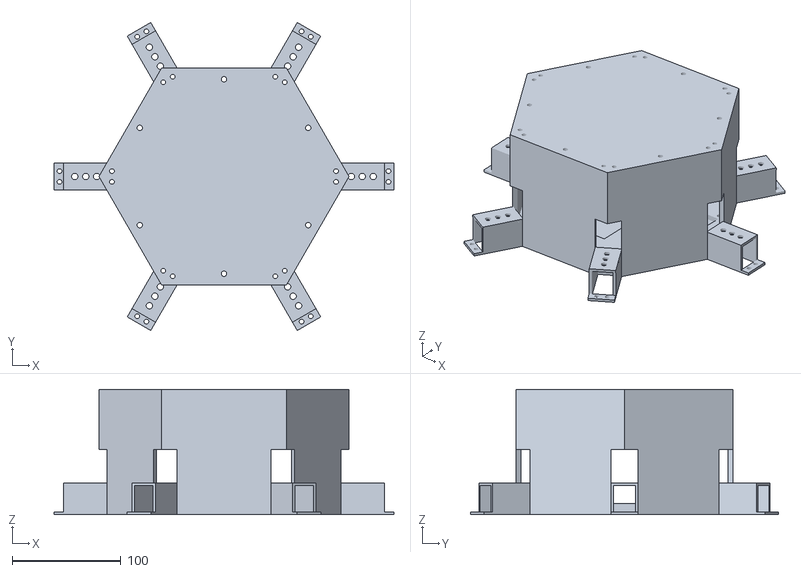
[picture p40: CAD file, 2026-08-08]
src/hexapod_description/meshes/visual/body test.stl
312.7 x 283.3 x 115.0
