rushikeshtangirala/hexapod_new/src/hexapod_description/meshes/visual/coxa new.stl

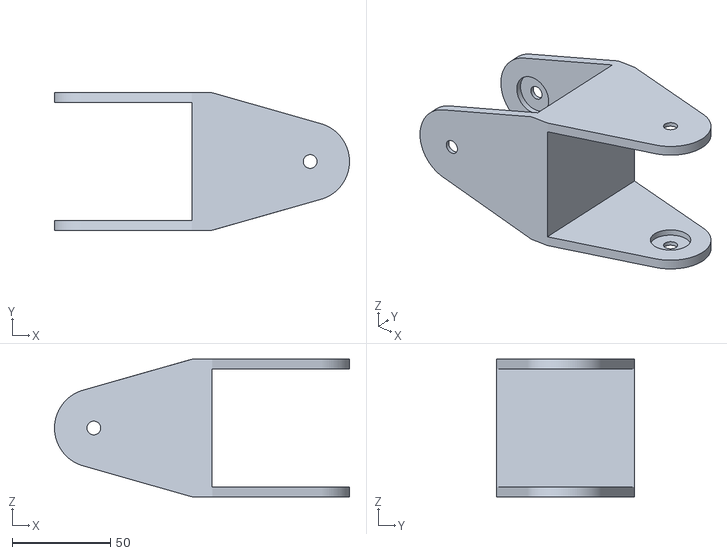
[picture p41: CAD file, 2026-08-08]
src/hexapod_description/meshes/visual/coxa new.stl
150.0 x 70.0 x 70.0
