rushikeshtangirala/hexapod_new/src/hexapod_description/meshes/visual/tibia final.stl

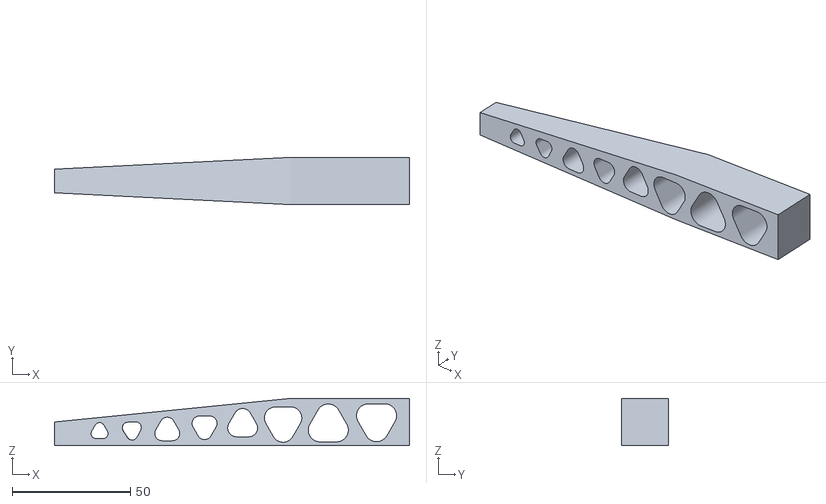
[picture p42: CAD file, 2026-08-08]
src/hexapod_description/meshes/visual/tibia final.stl
150.0 x 20.0 x 20.0
