rushikeshtangirala/hexapod_new/src/hexapod_description/meshes/visual/washer test.stl

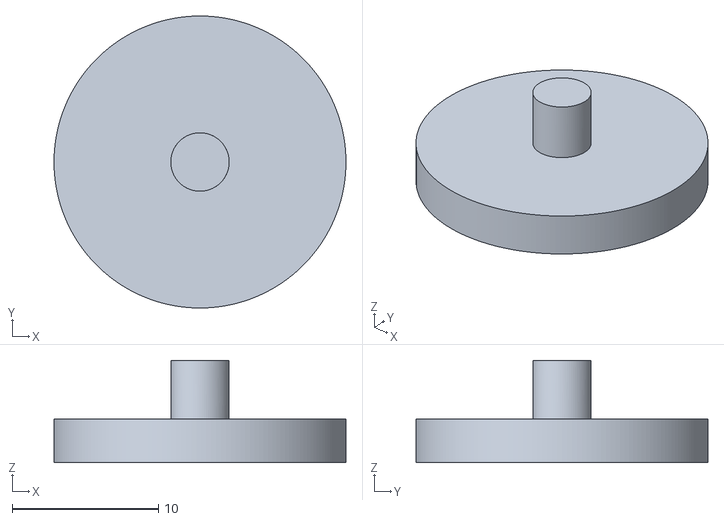
[picture p43: CAD file, 2026-09-12]
src/hexapod_description/meshes/visual/washer test.stl
20.0 x 20.0 x 7.00
