rushikeshtangirala/hexapod_new/(list of files, cad)

Other CAD files:
src/hexapod_description/meshes/visual/femur_raw.stl
src/hexapod_description/meshes/visual/femur bottom.stl
src/hexapod_description/meshes/visual/femur top blah.stl
