rushikeshtangirala/hexapod_new/(commit log)

2026-08-08 feat: workspace, tooling, and CAD-derived 18-DOF hexapod description
    [body test.stl, common_properties.xacro, coxa new.stl, femur bottom.stl, femur top blah.stl, hexapod.urdf.xacro, leg_macro.xacro, tibia final.stl]
2026-08-08 fix(description): remove illegal double hyphens from XML comments; add check_xml lint
    [common_properties.xacro, hexapod.urdf.xacro, leg_macro.xacro]
2026-08-11 Knee-down IK branch matching CAD, servo friction model, automated walk test
    GEOMETRY / KINEMATICS
    - Inverse kinematics now selects the POSITIVE law-of-cosines root, so the
    femur reaches outward (15.4 deg) and the tibia hangs down (+67.8 deg).
    This matches the CAD assembly; the previous negative root folded the leg
    the opposite way, with the femur vertical and the tibia nearly horizontal.
    - Consequence: the horizontal lever from knee to foot falls from 136 mm to
    18 mm, so knee torque falls from 1.48 to 0.19 N*m for the same stance.
    The measured 24.3 deg tibia sag disappears and the body holds its design
    height of 0.194 m.
    - femur limit returns to 90 deg (was 120). The offset servo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
    [body.stl, common_properties.xacro, controllers.yaml, coxa.stl, femur_lower.stl, femur_upper.stl, hexapod.gazebo.xacro, hexapod.ros2_control.xacro]
2026-08-11 fix(gait): stance swept feet forward, dragging every planted foot at 2x speed
    The stance phase applied stride_vector as +stride/2 -> -stride/2, but
    stride_vector already returns a backward displacement. Negated twice, so a
    planted foot was driven forwards through the body frame at the body's own
    speed: 0.16 m/s of slip over the ground at a commanded 0.08 m/s, on all
    three loaded legs simultaneously. This is the 'cycles its legs but does not
    travel' behaviour.
    verify_gait.py passed throughout because its non-slip check compared
    magnitudes, and a magnitude cannot see a sign. Now compared as vectors,
    plus an explicit assertion that stance pushes the way we asked.
    Also:
    - swing profile: cycloi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
    [common_properties.xacro, leg_macro.xacro]
2026-08-11 feat(sim): sim_profile:=repo mirrors hexapod_ros physical assumptions
    Adds a switch selecting which set of physical assumptions the model is
    built with. Default is unchanged.
    physical measured masses, closed-form inertias, derived joint limits,
    our tuned gains. What the report is about.
    repo KevinOchs/hexapod_ros: 1e-5 kg links, identity inertia tensors,
    plus/minus pi limits, 6 N m / 0.524 rad/s, no joint dynamics,
    p=100 i=0 d=0.
    repo mode is non-physical and stable because of it: gravity torque at 1e-5 kg
    is negligible so a crude PID has thousands of times the authority it needs,
    and a 1.0 kg m^2 tensor on such a link is far too reluctant to r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
    [common_properties.xacro, controllers_repo.yaml, hexapod.ros2_control.xacro]
2026-08-11 tools: collect_evidence.sh, one-shot runtime capture
    'It is not working' covers at least eight distinct faults here, needing
    opposite fixes. This captures every discriminating signal in one pass:
    which model is loaded, controller states, whether anything is subscribed to
    the command topic, command rate, commanded vs measured joint tracking, and
    ground-truth body pose before, during and after a self-issued drive command.
2026-08-11 test(autotest): preflight that catches plugin-load failures, and profile sweep
    The current failure (gzserver running, no controller_manager, list_controllers
    blocking forever on a service that will never exist) was invisible to the old
    script: it waited on a CONTROLLER becoming active, which cannot happen when
    the controller MANAGER was never created.
    Adds:
    - wait_for_controller_manager, separate from wait_for_controller_active, so
    'plugin never loaded' and 'controller failed to activate' report as the
    different faults they are
    - preflight that expands the model for each configuration, extracts the
    <parameters> path the gazebo_ros2_control plugin will be handed, and checks
    that file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
2026-08-11 test(autotest): probe the all-zeros case, and settle properly between configs
    First real sweep (2026-08-12) gave:
    B position/physical marches in place, 0.4 mm travel in 20 s
    C effort/repo WALKING, 99 percent speed tracking
    D effort/physical /odom and /joint_states both exactly zero
    D is not a collapsed robot. A collapsed robot has non-zero angles and a
    diverged one has huge values or NaN; identity on both streams means the
    world being measured is not the world the gait is driving. The gait node's
    own log for that run shows the robot standing correctly at stance, which
    rules out the robot and implicates the harness.
    Most likely a survivor from config C: DDS keeps stale endp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
2026-08-11 test(autotest): timeline sampler and WATCH mode for the config D contradiction
    D reports, simultaneously: model present in the world (get_model_list shows
    'hexapod'), one gzserver, one publisher per topic, physics stepping, the gait
    node reading real joint angles (femur +0.2343) at ramp time, and the
    measurement reading exactly zero for both /odom and /joint_states.
    Those cannot all hold at one instant, so the missing datum is when it changed.
    Adds a sampler that records /odom and /joint_states every 2 s across the whole
    measurement and prints the result as a timeline:
    zero from sample 1 -> plumbing; we are measuring something that is not
    this robot
    real the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
2026-08-11 test(autotest): ask Gazebo for the pose directly, not the p3d plugin
    The D timeline shows /odom identically zero from the FIRST sample, at t+2 s,
    before the ramp and before any velocity command, while the gait node reads
    correct joint angles throughout the same run. A ground-truth sensor reading
    zero from t=0 is not observing a robot that fell over; it is not observing.
    So /odom is not admissible evidence about config D, and every D verdict so
    far ('ROBOT NOT IN THE WORLD') is void: it was a statement about the sensor.
    The timeline now samples get_entity_state alongside /odom. That asks the
    simulator for the model pose directly, and being a service call it also
    avoids the QoS message loss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
2026-08-11 fix(measure): stop trusting p3d as the only source of body pose
    THE FAULT
    control_mode:=effort with sim_profile:=physical was scored 'ROBOT NOT IN THE
    WORLD' three consecutive runs. /odom published position (0,0,0) orientation
    (0,0,0,1) from the FIRST sample, before the startup ramp and before any
    velocity command, while /joint_states reported correct angles throughout and
    get_model_list confirmed the robot was present in the world.
    p3d was not observing a robot that had fallen over. It was not observing.
    All three verdicts were statements about the sensor, and that configuration
    has never actually been measured.
    THE FIX
    Declare libgazebo_ros_state.so in the WORLD file, not on the robot, s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
2026-08-11 test(autotest): query a LINK pose, not just the model pose
    Gazebo's own state plugin now agrees with p3d: model 'hexapod' sits at exactly
    (0,0,0) for the entire run in config D, while /joint_states shows the legs at
    correct stance angles throughout. Two independent sources, same answer, so p3d
    was not at fault and the earlier 'dead sensor' conclusion was wrong.
    A body at the origin with correct joint angles and no motion at all is pinned,
    not fallen and not missing.
    Model pose and link pose are not the same thing, so the timeline now also
    queries hexapod::lf_foot_link:
    model 0, foot sensible and moving -> only model-frame reporting is broken
    model 0, foot 0 -> the ba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
2026-08-12 feat(demo): kinematic demonstration mode, body pose driven by the gait
    DELIVERABLE FOR THE REVIEW. One command, robot walks, cannot be thrown.
    Every Gazebo failure this project has had is one failure: a floating base on
    six frictional contacts. Measured across three configurations:
    position + measured model legs swing 10 deg, body travels 0.4 mm / 20 s
    effort + hexapod_ros model walks at 99 percent tracking, climbs 5 cm,
    tilts 12 deg
    effort + measured model body pinned at the origin, unresolved
    What is demonstrably NOT at fault: the gait (498 offline assertions including
    a signed non-slip test), the IK (round trip 3.5e-16 m), the URDF (mounts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
    [common_properties.xacro, hexapod.urdf.xacro, leg_macro.xacro]
2026-08-14 fix(demo): eliminate foot slip, add scripted sequence, TF and distance markers
    SLIP HAD A SPECIFIC CAUSE, AND IT WAS NOT PHYSICS.
    stride_vector() clamps stride magnitude at max_stride while preserving
    direction. With cycle_time 2.0 s the stance lasts 1.0 s and the furthest foot
    sits 0.3971 m from the body centre, so:
    forward 0.08 m/s needs 80.0 mm under the 100 mm limit
    turn 0.40 rad/s needs 158.8 mm CLAMPED
    both needs 232.0 mm CLAMPED
    On a turn the legs took a 100 mm stride while body_driver rotated the body at
    the full commanded rate. The legs under-strode by more than a third and the
    feet slid to make up the difference, which is why it loo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
2026-08-14 docs(review): presentation pack, and raise body driver rate to 100 Hz
    The residual stutter is a rate mismatch, not a physics artefact: each
    set_entity_state is a discrete relocation, so the body advanced in 20 ms steps
    while the legs were integrated at 1000 Hz. 100 Hz halves the step and puts the
    residual below what the eye resolves. The outstanding-request guard means this
    degrades gracefully rather than building a backlog if Gazebo cannot keep up.
    docs/REVIEW.md: the argument in one paragraph, a 14 slide plan, every number
    with its source, the demo runbook, seven anticipated questions with answers,
    and a two day schedule.
    The framing throughout is that the contribution is the METHOD, not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
2026-08-15 docs(review): first review report and presentation
    Report: 13 pages covering the model, architecture, kinematics, gait,
    simulation, verification approach, results, status and further work. Every
    figure quoted is reproducible from the tools in this repository.
    Deck: 14 slides. The three that carry the argument are the sign error and why
    our own test could not have caught it, the comparison of three simulation
    configurations with an explanation of each, and the honest status slide.
    Both leave student names, guide and institution as bracketed placeholders.
2026-08-15 fix(control): activate velocity feedforward; complete the 2x2 config matrix
    ff_velocity_scale was being rejected on every start, eighteen times:
    'ff_velocity_scale' parameters is not defined under 'gains.<joint_name>.'
    structure. Maybe you are using deprecated format 'ff_velocity_scale/<joint>'
    Not cosmetic. The parameter was absent in the form this controller version
    reads, so the term defaulted to zero and the velocity feedforward described in
    ARCHITECTURE.md has been inactive for every run recorded so far. gait.py
    computes those velocities by finite difference and the node publishes them, so
    the information was being sent and discarded.
    It matters most under effort control: a pure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
    [controllers.yaml, controllers_repo.yaml]
2026-08-17 docs(review): simpler deck with space for CAD, ANSYS and simulation images
    Rewritten for a first review audience. Fewer words on screen, larger type, and
    the explanation moved into speaker notes so the slides are talked over rather
    than read out.
    19 slides, all with speaker notes, and 11 empty framed placeholders for the
    team's own pictures:
    AutoCAD assembly, isometric and top view
    Exploded view of one leg and the printed parts
    ANSYS stress and deformation plots, with a load case line to fill in
    RViz model and coordinate frames
    Gazebo standing and mid-stride
    Leg geometry diagram
    Demo video frame
    New slides for the mechanical design and the structural analysis, which the
    prev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
2026-08-17 docs: crib sheet for the review
    One page covering the launch sequence step by step (including the exact
    spawn_entity call and why spawn height is not a free number), the data flow
    with its three rates and the reason for each, the five packages and why they
    are separate, every figure with its source, and short answers to the questions
    most likely to be asked.
2026-08-22 docs(review): v2 deck with kinematics equations, mechanism, MATLAB and Gazebo results
    Rebuilt after guide feedback asking for the kinematics equations, more
    mechanical content around the simulation, and proper explanation of the MATLAB
    graphs. 28 slides, all with speaker notes.
    New analytical content, six typeset equation panels:
    forward kinematics in the leg plane and lifted to 3D
    inverse kinematics, all four steps with the law of cosines
    reachability annulus with our link lengths substituted
    velocity kinematics and the singular configurations
    per-leg stride derivation including the yaw rate terms
    swing profile, horizontal cubic and vertical raised cosine
    New figures generated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
2026-08-22 docs: full explanation of kinematics, Gazebo results, MATLAB plots and future work
    Study document behind the slides.
    Kinematics derived step by step: the parallel-axis argument that collapses 3D
    to 2D and makes a closed form possible, forward equations built term by term,
    inverse in four steps with the reasoning for atan2 and for the law of cosines,
    the reachability annulus with our numbers, the elbow branch comparison
    including the eight-fold knee torque difference and the servo horn offset it
    implies, and velocity kinematics with the singularity check.
    Gazebo results as six measured findings with numbers: 2.37 degree worst joint
    sag holding 3.39 kg, controller tracking to four decimals,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
2026-08-28 docs(review): benchmark comparison slides and delivery guide
    Adds two slides positioning the project against Xiang et al. 2024, Frontiers
    in Robotics and AI 11:1426269, a bionic hexapod for agricultural field
    scouting. Chosen because it is nearly the same machine: six legs, three DOF,
    tripod gait as the base, kinematics presented, simulation before hardware.
    The substantive contrast is that the paper deliberately avoids inverse
    kinematics at run time, using sinusoidal joint modulation on the grounds that
    IK is computationally expensive. That objection applies to numerical IK. Ours
    is closed form, so it is a fixed cost with no iteration, and it buys the
    ability to command a body velocity dir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
2026-08-28 docs(review): trim deck to 23 slides, split the paper comparison out
    Guide feedback: 30 slides is too long, and the benchmark comparison should not
    sit inside the main deck.
    Removed seven slides. Two were the paper comparison, now a standalone
    one-slide file. Five were supporting material that the guide's priorities do
    not need: velocity kinematics, Gazebo physics parameters, software package
    layout, the control chain diagram, and workspace reachability. The mechanical,
    kinematic, MATLAB and Gazebo content he asked for is untouched.
    Paper_Comparison.pptx is a single slide with the full comparison table and
    extensive speaker notes, kept separate so it can be shown only if the topic
    comes up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
2026-08-29 docs(review): theta1 written as arctan(y/x), and the paper summary as a document
    Inverse kinematics slide now shows the coxa angle in the conventional form
    arctan(y/x). The slide-by-slide guide gains the answer for the obvious
    follow-up question, which is why step 4 still writes atan2: they are the same
    idea, and atan2 is the two-argument form that resolves the quadrant and avoids
    dividing by zero, which matters for the legs on the right-hand side where x
    goes negative.
    Research_Paper_Summary.docx carries the team's own summary of Zhang, He, Wu,
    Quesada and Xiang 2024, properly typeset with the specification table, plus a
    comparison section against our project. Corrects the mass figure to t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
2026-08-29 docs(review): write beta as arctan(-z/r') to match theta1
    Step 4 of the inverse kinematics now uses the same one-argument form as step
    1, so the slide is internally consistent. Same angle either way; the guide
    note explains that the code evaluates it as the two-argument atan2 so the
    quadrant is resolved correctly for the right-hand legs, where x goes negative.
2026-09-13 Project state 2026-09-14
    Checkpoints 1 to 6 and 8 complete.
    MODEL
    - Visual meshes sit on their correct links. The earlier coxa/tibia
    visual exchange in leg_macro.xacro has been removed: coxa.stl is
    the forked clevis at the body, tibia.stl the truss at the foot.
    - hexapod.sensors.xacro adds IMU, forward camera and lidar, each
    behind its own flag. Camera and lidar default off because
    rendering roughly halves the real time factor.
    BUG: SPAWN HEIGHT AND WORLD ANCHOR WERE ADDING
    - With fix_base true, spawn_entity -z placed the whole model and the
    world weld then applied on top, so the body sat at 0.16 + 0.132 =
    0.292 m with the feet 0.16 m clear of the ground. Every anchored
    run s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
    [hexapod.sensors.xacro, hexapod.urdf.xacro]
